biggis-project/weather-sensors/(threads)

Thread 2 (2016-02-23):

Physical design for the sensor gateway

vsimko, 2016-02-23:
Currently, we only have the design for a sensor node which fits into 100x60x25 plastic box.

If we use the same box for the gateway, the problem is that the distance between the USB and ethernet port does not match the box dimensions.

vsimko, 2016-02-24:
A cheap solution might be to enclose the device between two wooden or plastic plates.
The gateway does not need to be fancy anyways.

vsimko, 2016-04-20:
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

Closed 2016-04-20.

Thread 4 (2016-02-24):

Software SPI for sensor node not neede

vsimko, 2016-02-24:
Currently, I'm using Software SPI for both sensor and gateway. This is because the Arduino Nano ethernet shield cannot be used together with other SPI device. However, the sensor node can use the standard SPI which might even simplify wiring on PCB.

Thread 7 (2016-03-01):

Sensor node: PCB

vsimko, 2016-03-01:
Design PCB for the sensor node using e.g. `Fritzing` and order printing at [PCBPool](https://www.pcb-pool.com)

Sensor PCB: 43x20mm @ 2.91 EUR/item

vsimko, 2016-04-20:
Found another company that might be cheaper:http://www.pcbway.com/cc

Thread 8 (2016-04-20):

Final soldering for the gateway

vsimko, 2016-04-20:
To be soldered on gateway PCB:
- 2x rows of 15pin female header (for the ethernet module)
- 2x rows of 4pin female header (for RF module)
- ceramic capacitor (for RF module)
- 7x color cables between ETH module and RF module

vsimko, 2016-04-28:
The hole at the top cover is not needed anymore. I'll use **40mm M3 spacer** instead of 30mm.

vsimko, 2016-04-28:
The wiring schema is depicted here (bottom view):
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

There is one capacitor between GND and VCC pins of the NRF24L01+ module. Different sources suggested different capacitance ranging from 0.1uF to 220uF. For the gateway, this is not as important as for the sensor.

Thread 9 (2016-04-28):

Problem with NRF24L01+ clones

vsimko, 2016-04-28:
I bought two versions of the NRF24L01+ module, both from China. The cheaper version, however, causes problem when transmitting.

**This one works**
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

**This version does not work**
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

[RF24]: https://github.com/TMRh20/RF24
[nRF24L01p_SoftSPI]: https://github.com/vsimko/nRF24L01p_SoftSPI

**Notes**
- If I use the library [nRF24L01p_SoftSPI] and try to transmit some data, the whole Arduino hangs and disconnects from USB.
- With the [RF24] library, the transmission does not freeze the MCU but nothing is being transmitted.
- I can, use both versions with the [RF24] as a receiver, however ACK needs to be disabled. I suspect that this might have something to do with Si24R1 chip that has ACK bit inverted.
- Both versions can be operated from the 3.3V pin on Arduino Nano v3 but the PA Level needs to be `RF24_PA_LOW`.
- By providing a separate 3V source to the fully working module from 2xAA batteries (with GND shared with Arduino), I could use `RF24_PA_HIGH`, but never `RF24_PA_MAX`.

vsimko, 2016-04-28:
From section 10.4 of the Nordic Semiconductor spec sheet for the NRF24L01+:

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

vsimko, 2016-04-28:
See also this post:
http://forum.mysensors.org/topic/1153/we-are-mostly-using-fake-nrf24l01-s-but-worse-fakes-are-emerging

vsimko, 2016-05-11:
I don't want to waste time with the cheap buggy units.
I just ordered a new set of the working "YJ-15008+PA" units from eBay (2.90 EUR each)

vsimko, 2016-05-27:
Interestingly, when the units arrived, they looked exactly as those cheap non-working clones, although I ordered specificly the "YJ-15008+PA" model. However, **these units are working**.
Only 1 of these 28 units doesn't work, but that's probably other story.

Closed 2016-05-11.
