biggis-project/weather-sensors/MyTransmitter_softSPI/MyTransmitter_softSPI.ino

#include <SoftSPI.h>
#include <nRF24L01p.h>

nRF24L01p transmitter(8,7);//CSN,CE

void setup(){
  delay(150);
  Serial.begin(9600);
  transmitter.channel(90);
  transmitter.TXaddress("wsdataT");
  transmitter.RXaddress("wsdataR");
  transmitter.init();
  Serial.println("I'm transmitter");
}

int i = 0;

void loop() {
  
  const String msg = String(i);
  
  Serial.println(msg);
  Serial.flush();
  
  transmitter.txPL(msg);
  transmitter.send(true);
  delay(1000);
  i++;
}
