biggis-project/weather-sensors/(commit log)

2015-09-15 First working prototype that reads DHT22 humidity/temperature and also data from a 10K Thermistor
2015-09-15 first working RF transmit/receive between two Arduinos
2015-09-15 Working RF transmitter + receiver that sends temperature+humidity from DHT22 and temperature from a thermistor
2015-09-16 now loading sensor id and smode from EEPROM the smode button also works
2015-09-17 refactored thermistor and crc code into separate files
2016-01-18 Working setup that uses software SPI. This is needed when combining nrf24l01p with ENC28J60
2016-01-18 Working setup that also includes DHT22 sensor
2016-01-18 Experiment using iBoard library (did not work)
    [using_iboard.ino]
2016-01-18 Experiment with mirf library (did not work)
    [using_mirf.ino, using_mirf_recv2.ino, using_mirf_send2.ino]
2016-02-13 added support for low-power sleep mode
2016-03-02 sensor prototype photo
    added photo of the first sensor prototype with FZI logo
2016-04-25 added sketch of the gateway prototype in ODG format
2016-04-25 photo of the sensor
2016-04-25 photos of the sensor node
2016-04-25 updated orthophoto of the sensor node
