biggis-project/weather-sensors/(notices)

Notices in the files:
DHT22-WorkingPowerOnPin5/prescaler.h:
it under the terms of the GNU General Public License as published by
the Free Software Foundation, either version 3 of the License, or
(at your option) any later version.
